janjordan3/SoftFoot/README.md

# Projekt-Repository: SoftFoot / Plantar Fascia Modul & Druckmatrix

Willkommen im Repository dieses Projekts. Dieses Repository enthält die vollständige Dokumentation der Konstruktion, Materialanalysen, Python-Skripte zur Datenerfassung und Visualisierung sowie alle zugehörigen Anhänge.

---

## 📁 Repository-Struktur & Dateiübersicht

Eine schnelle Übersicht zur Orientierung im Repository:

```text
├── README.md                                                       # Hauptdokumentation / Projektübersicht
├── docs/                                                           # Ausführliche Dokumentationen & Anhänge
│   ├── Anhang_A_KI_Nutzung.md                                      # Anhang A: Erklärung zur Nutzung von KI
│   ├── Anhang_B_Materialeigenschaften.md                           # Anhang B: Materialeigenschaften PETG HF
│   └── Anhang_C_Bauteildokumentation.md                            # Anhang C: Konstruktion & Technischer Anhang
│   └── Anhang_D_Testprotokoll_Tensegrity_Achse.pdf                 # Anhang D: Testprotokoll
│   └── Anhang_E_Mathematische Formeln WPS und Active Area.pdf      # Anhang E: Mathematische Formeln WPS und Active Area
├── src/                                                            # Python-Skripte zur Druckmatrix
│   ├── 01_visualization_heatmap.py                                 # Script 1: Visualisierung der Druckmatrix
│   └── 02_data_acquisition.py                                      # Script 2: Auswertung (Active Area & WPS)
└── assets/                                                         # Bildmaterial & Diagramme
    └── foot_demo.png                                               # Abbildung zur Untergrundanpassung
