janjordan3/SoftFoot/docs/Anhang E | Mathematische Formeln WPS und Active Area.pdf

Mathematische Formeln | Tensegrity-Fußdruckanalyse

# Tensegrity-Fußdruckanalyse: Mathematische Formeln

### Methodik & Algorithmus-Dokumentation

Dieses Dokument beschreibt die präzisen Formeln, die vom automatisierten Auswertungsskript verwendet werden, um die aktive Kontaktfläche (Prozentsatz der Fußabdruckfläche) und den Weighted Pressure Score (WPS) aus den Bildern der Drucksensormatrix zu berechnen.

## 1 Pixel-Klassifizierung & Farbzuordnung

Die Sensormatrix zeichnet Daten auf einem Raster aus Zellen auf. Jede Zelle entspricht einer bestimmten Farbe, die ein Druckniveau basierend auf den ADC-Kalibrierungsschwellen darstellt:

- Gelb: Maximaldruck (100% Gewichtung)
- Orange: Hoher Druck (75% Gewichtung)
- Rot: Geringerer Druck (50% Gewichtung)
- Lila: Kaum Kontakt / Geringer Schwellenwert (25% Gewichtung)
- Schwarz: Kein Kontakt / Hintergrund (0% Gewichtung)

Seien die Pixelanzahlen für jede Farbe wie folgt definiert:

PY = Gelbe Pixel
PO = Orangene Pixel
PR = Rote Pixel
PP = Lila Pixel
PB = Schwarze Pixel (Hintergrund)

## 2 Gesamte Matrixfläche

Die relevante Gesamtsensorfläche (Ntotal) ist definiert als die Summe aller aktiven Kontaktpixel plus der inaktiven schwarzen Pixel innerhalb der zugeschnittenen Matrixbegrenzung:

Ntotal = PY +PO +PR +PP +PB

## 3 Aktive Kontaktfläche (Prozentsatz der Fußabdruckfläche)

Die aktive Kontaktfläche stellt den Anteil des Sensorrasters dar, der von der Fußstruktur aktiv beansprucht wird (jede Zelle, die einen Druck oberhalb des Schwellenwerts aufzeichnet, d. h. nicht-schwarze Pixel):

Aktive Kontaktfläche (%) =

(︃
PY +PO +PR +PP
Ntotal | )︃ ×100

Mathematische Formeln | Tensegrity-Fußdruckanalyse

## 4 Weighted Pressure Score (WPS)

Der Weighted Pressure Score berücksichtigt sowohl die Kontaktfläche als auch die Druckintensität. Jede Farbkategorie wird mit einem standardisierten Druckgewichtungskoeffizienten multipliziert:

Gelber Koeffizient = 1,00
Oranger Koeffizient = 0,75 Roter Koeffizient = 0,50
Lila Koeffizient = 0,25

Die gewichtete Summe (Wsum) wird berechnet als:

Wsum = (PY ×1,0) + (PO ×0,75) + (PR ×0,50) + (PP ×0,25)

Schließlich wird der Prozentsatz des Weighted Pressure Score (WPS) auf die gesamte Matrixgröße normalisiert:

WPS (%) =

(︃
Wsum

Ntotal)︃
×100
