janjordan3/SoftFoot/docs/Anhang C | Materialeigenschaft PETG.md

### Tabelle 2: Ausgewählte Materialeigenschaften PETG HF

| Eigenschaft | Symbol | Wert |
| :--- | :---: | :---: |
| Dichte | $\rho$ | $1{,}28\text{ g/cm}^3$ |
| Zugfestigkeit | $\sigma_{\text{zug}}$ | $34 \pm 4\text{ MPa}$ |
| Bruchdehnung | $\varepsilon_B$ | $8{,}6 \pm 1{,}2\,\%$ |
| Biege-E-Modul | $E_{\text{Bieg}}$ | $2050 \pm 120\text{ MPa}$ |
| Biegefestigkeit (XY) | $\sigma_{\text{Bieg},XY}$ | $64 \pm 3\text{ MPa}$ |
| Vicat-Erweichungstemperatur | $T_{\text{Vicat}}$ | $70\text{ °C}$ |
| Wärmeformbeständigkeit ($0{,}45\text{ MPa}$) | $T_{\text{HDT}}$ | $69\text{ °C}$ |
