janjordan3/SoftFoot/docs/Anhang A | KI-Reflection.md

## Erklärung zur Nutzung von Künstlicher Intelligenz (KI)

Die KI-Nutzung in dieser Ausarbeitung beschränkte sich auf formale, sprachliche und visuelle Unterstützung. Die inhaltlichen und mathematischen Erarbeitungen erfolgten vollständig eigenständig. 

Die KI wurde in den folgenden Bereichen eingesetzt:

* **Sprache:**
  * Überprüfung von Grammatik, Rechtschreibung und akademischem Schreibstil.
  * Unterstützung bei der Umsetzung von Passivkonstruktionen und der Integration von Fachvokabular (z. B. *„hysteresebehaftet“*).

* **Formatierung & LaTeX:**
  * Unterstützung beim grundlegenden Aufbau des Dokuments in LaTeX sowie bei der Erstellung des fehlerfreien Codes.
  * Übersetzung eigener mathematischer Herleitungen in passende LaTeX-Umgebungen (z. B. `align`) unter Einbindung der benötigten Pakete.

* **Zitierweise & Verzeichnisse:**
  * Prüfung aller Quellenverweise und des Inhaltsverzeichnisses zur Gewährleistung eines fehlerfreien Zitierstils nach IEEE.

* **Prototyping & Softwareentwicklung:**
  * **Bauteilrecherche:** Einsatz von *Google Gemini* zur Recherche benötigter Bauteile und Alternativen für das Design der Druckmatrix.
  * **Heatmap-Visualisierung:** Umsetzung eines Python-Skripts zur Visualisierung der Heatmap mit Unterstützung von *Anthropic Claude*.
  * **Datenauswertung:** Erstellung eines Python-Skripts zur Auswertung der *Active Area* und des *WPS* der Testreihen mit Unterstützung von *Anthropic Claude*.

* **Berichterstellung:**
  * Einsatz von *Google Gemini* als stilistische Formulierungshilfe und für punktuelle Nachfragen zur Strukturierung.
  * *Hinweis:* Die Formatierung und Gliederung wurden größtenteils aus erfolgreichen Projektberichten vergangener Semester (basierend auf Erfahrungen aus dem MPEC-Studium) übernommen.
