janjordan3/SoftFoot/(commit log)

2026-09-11 Visualizer for the pressure matrix
2026-09-13 Add material properties table for PETG
2026-09-13 Rename pressure_matrix_visualizer (1).py to visualization_heatmap.py
2026-09-13 Rename Anhang B | Strukturelle Komponenten und Gelenkdesign.md to docs/Anhang B | Strukturelle Komponenten und Gelenkdesign.md
2026-09-13 Rename Anhang C | Materialeigenschaft PETG.md to docs/Anhang C | Materialeigenschaft PETG.md
2026-10-05 Rename Mathematische Formeln WPS und Active Area.pdf to Anhang E | Mathematische Formeln WPS und Active Area.pdf
